OP-Patel/optical-dsp/docs/hardware/xadc-interface.md

# Arty A7 XADC interface record

This file is the configuration and measurement record for Milestone 06. Fill
the measurement fields from the implemented design and physical tests; do not
replace missing values with estimates.

## Fixed board mapping

| Item | Selection |
|---|---|
| Board input | ChipKit A0, single-ended 0-3.3 V board-scaled input |
| XADC auxiliary channel | VAUX4 |
| Positive FPGA package pin | C6, top-level `vaux4_p` |
| Negative FPGA package pin | C5, top-level `vaux4_n` |
| DRP result address | `7'h14` |
| Result extraction | `DO[15:4]` |

Physical A0 is a single input referenced to board ground. The two VAUX4 FPGA
ports are the internal differential connection after the Arty scaling network;
they are not two external wires the user must drive independently.

## XADC configuration

| Setting | Implemented value | Reason/source |
|---|---|---|
| Primitive / generated core version | Direct 7-series `XADC` primitive, Vivado 2026.1 | `rtl/acquisition/xadc_single_channel.sv` |
| Conversion mode | Single-channel continuous conversion | `INIT_41=16'h3000` selects sequencer-off single-channel mode |
| Selected channel | VAUX4/A0 | `INIT_40=16'h0014` selects ADC channel 20 |
| Input mode | Unipolar | `INIT_40` bipolar bit is zero |
| DCLK | 100 MHz system clock | Direct connection to `clk_100mhz` |
| XADC clock divider | 16 | `INIT_42=16'h1000` |
| Calculated ADCCLK | 6.25 MHz | `100 MHz / 16` |
| Nominal conversion rate | Approximately 240,385 samples/s | `6.25 MHz / 26` with acquisition extension disabled |
| Measured `sample_valid` rate | Pending | Count events over a known time |
| Averaging | Disabled | `INIT_40` averaging bits are zero |
| Acquisition extension | Disabled for initial bring-up | `INIT_40` acquisition bit is zero; revisit for high source impedance |
| Voltage reference | Board XADC reference wiring; no runtime selection in RTL | Confirm the physical reference arrangement from the Arty schematic during calibration |
| Calibration | Coefficient application disabled | `INIT_41` calibration-enable bits are zero |
| Alarms | Primitive outputs intentionally unused | Acquisition faults are generated by the DRP controller |
| Primitive configuration values | `INIT_40=0014`, `INIT_41=3000`, `INIT_42=1000`, `INIT_48`-`INIT_4F=0000` | Exact values in checked-in adapter |

## Nominal conversion equation

For the Arty A0 0-3.3 V scaled path:

```text
expected_code = round((applied_voltage / 3.3 V) * 4095)
estimated_voltage = measured_code * 3.3 V / 4095
```

This equation is nominal. The measured table below is the acceptance evidence.

## Electrical measurements

| Applied voltage | Expected code | Mean code | Minimum | Maximum | Samples | Notes |
|---:|---:|---:|---:|---:|---:|---|
| Board ground (nominal 0 V) | 0 | 13.2988 | 11 | 16 | 1,024 | `artifacts/captures/a0-ground.csv` |
| Board 3V3 rail (nominal; not independently measured) | 4095 | 4070.5381 | 4067 | 4074 | 1,024 | `artifacts/captures/a0-3v3.csv` |

## Sample-rate measurement

| Field | Value |
|---|---|
| Measurement interval | Pending |
| `sample_valid` events counted | Pending |
| Measured samples/second | Pending |
| Expected samples/second | Pending |
| Difference and explanation | Pending |

## Acceptance notes

- [x] Codes increase monotonically between the two board-derived endpoints.
- [x] Grounded input offset and spread are recorded.
- [x] No `xadc_fault` occurred during either measurement window after BTN0 reset.
- [ ] The measured rate is consistent with the documented configuration.
- [x] Only board ground and the nominal board 3V3 rail were applied to A0.
- [x] The BPW34 was not used to hide an electrical acquisition issue.

The endpoint test is a functional range check, not a precision calibration,
because the board 3V3 rail was not independently measured. The observed
ground-corrected span is `(4070.5381 - 13.2988) / 4095 = 99.08%` of ideal full
scale.

## Sources

- [AMD UG480: 7 Series XADC User Guide](https://docs.amd.com/r/en-US/ug480_7Series_XADC)
- [AMD UG953: XADC primitive](https://docs.amd.com/r/2024.2-English/ug953-vivado-7series-libraries/XADC)
- [Digilent Arty A7-100 master XDC](https://github.com/Digilent/digilent-xdc/blob/master/Arty-A7-100-Master.xdc)
- [Local Arty reference manual](../datasheets/arty_rm.pdf)
- [Local Arty schematic](../datasheets/arty-a7-e2-sch.pdf)
