OP-Patel/optical-dsp/docs/evidence/milestone-04/tb_optical_framer.txt

#-----------------------------------------------------------
# xsim v2026.1 (64-bit)
# SW Build 6511674 on Tue Jun 16 11:02:23 MDT 2026
# IP Build 6504888 on Tue Jun 09 09:05:25 MDT 2026
# SharedData Build 6501428 on Mon Jun 08 17:34:18 MDT 2026
# Start of session at: Wed Aug 12 20:29:19 2026
# Process ID         : 32648
# Current directory  : C:/Users/Om Patel/Desktop/arty-optical-dsp
# Command line       : xsim.exe -log docs\evidence\milestone-04\tb_optical_framer.txt -mode tcl -source {xsim.dir/tb_optical_framer_m04/xsim_script.tcl}
# Log file           : C:/Users/Om Patel/Desktop/arty-optical-dsp/docs/evidence/milestone-04/tb_optical_framer.txt
# Journal file       : C:/Users/Om Patel/Desktop/arty-optical-dsp\xsim.jou
# Running On         : Om
# Platform           : Windows 11
# Operating System   : 26200
# Processor Detail   : Intel(R) Core(TM) Ultra 9 185H
# CPU Frequency      : 3072 MHz
# CPU Physical cores : 16
# CPU Logical cores  : 22
# Host memory        : 33945 MB
# Swap memory        : 8053 MB
# Total Virtual      : 41998 MB
# Available Virtual  : 17788 MB
#-----------------------------------------------------------
source xsim.dir/tb_optical_framer_m04/xsim_script.tcl
# xsim {tb_optical_framer_m04} -autoloadwcfg -runall
Time resolution is 1 ps
run -all
PASS: tb_optical_framer checks=9521 frames=2 seed_loads=2 prbs_advances=2048
$finish called at time : 28150 ns : File "C:/Users/Om Patel/Desktop/arty-optical-dsp/rtl/tb/tb_optical_framer.sv" Line 298
exit
INFO: [Common 17-206] Exiting xsim at Wed Aug 12 20:29:21 2026...
