OP-Patel/optical-dsp/docs/evidence/milestone-04/optical_framer_waveform.png

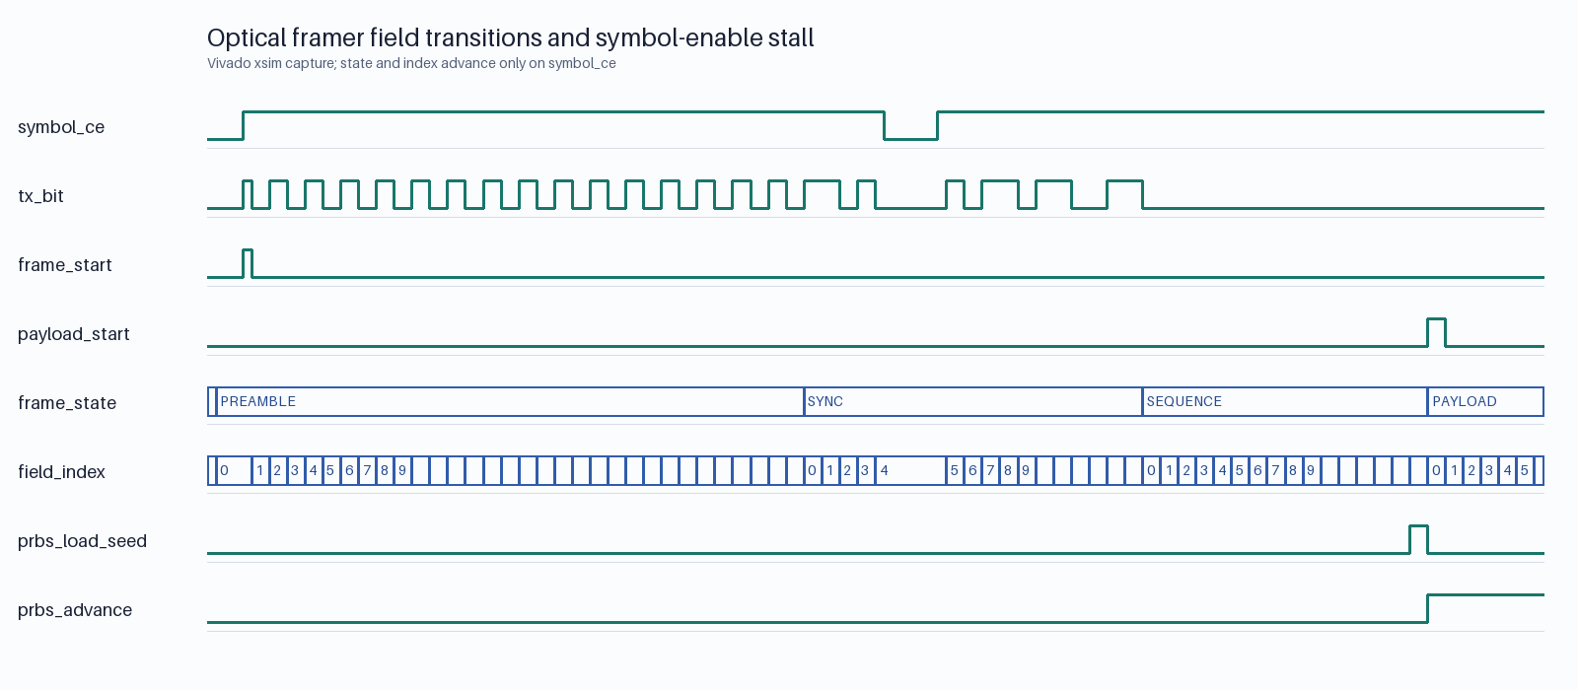
docs/evidence/milestone-04/optical_framer_waveform.png
