OP-Patel/optical-dsp/docs/hardware/board-inventory.md

FPGA Board: Arty A7-100T
Laser Module: KY-008 
Photodiode: BPW34/BPW34S (Silicon PIN)
