OP-Patel/optical-dsp/docs/evidence/milestone-05/physical-transmitter-test.md

# Physical transmitter functional test

| Field | Result |
|---|---|
| Date | 2026-08-13, America/Toronto |
| Observer | Project owner |
| Status | `PASS` |
| FPGA output | JA4 |
| KY-008 wiring | `S` to JA4, `-` to JA5 ground, middle pin unconnected |
| Observation | The programmed FPGA successfully controlled the physical KY-008 laser transmitter. |

This record documents the observed functional result reported by the project
owner. It does not claim loaded voltage/current measurements, full per-mode
waveform capture, or DAOKI receiver validation; those are tracked separately.
