OP-Patel/optical-dsp/(commit log)

2026-08-10 add schematics and datasheets
2026-08-13 add frame logic, finish m4
2026-08-13 add laser bringup, finish m5
2026-08-14 update wiring
2026-08-15 add UART packaging and packet decoding
2026-08-17 bpw34 pretest wiring
2026-08-21 add fir filter
